NiceCircuits/solderingPen/measurements/test_load_photo.jpg

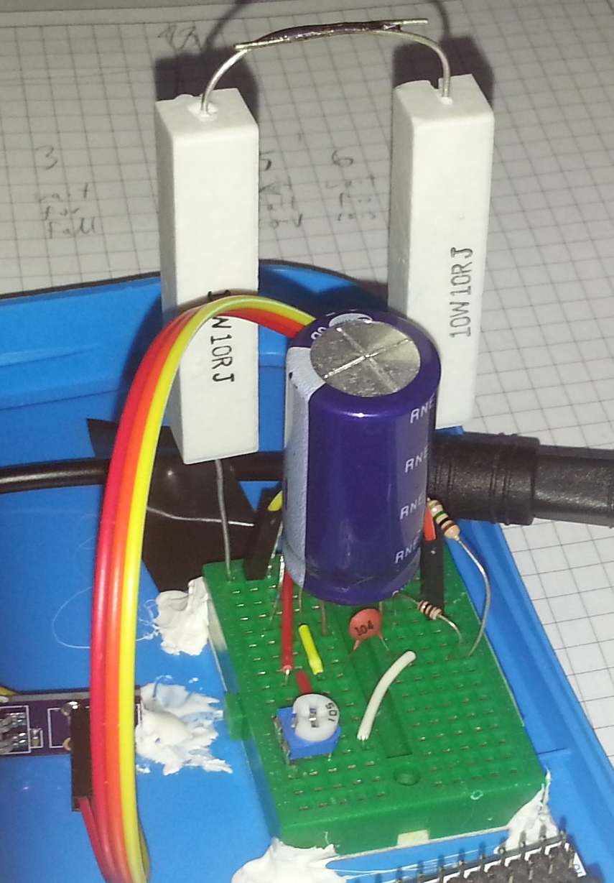
measurements/test_load_photo.jpg
