NiceCircuits/solderingPen/doc/img/bootloader_reception_1200.png

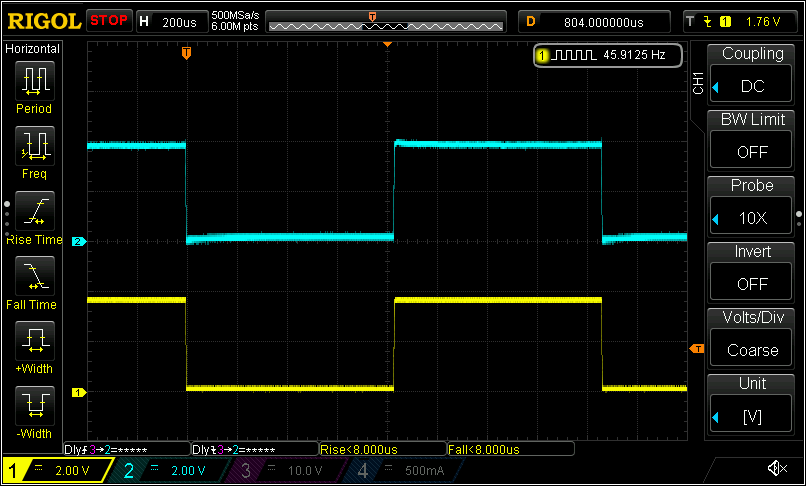
doc/img/bootloader_reception_1200.png
