NiceCircuits/solderingPen/doc/img/bootloader_reception_115200.png

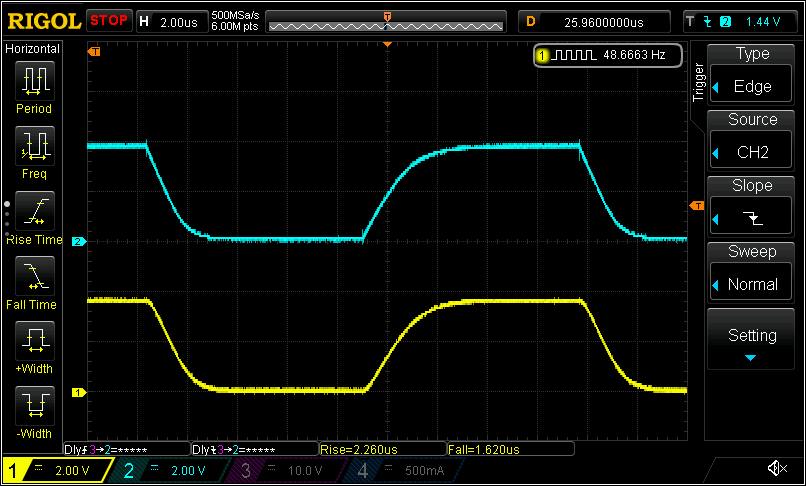
doc/img/bootloader_reception_115200.png
