NiceCircuits/solderingPen/doc/img/bootloader_reception_scm.png

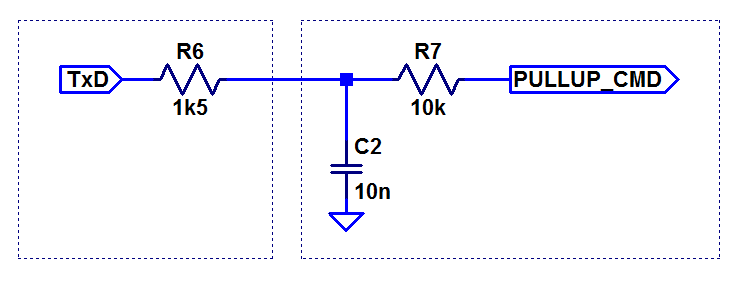
doc/img/bootloader_reception_scm.png
