NiceCircuits/solderingPen/doc/img/bootloader_transmission_high_side_2k2_220k.png

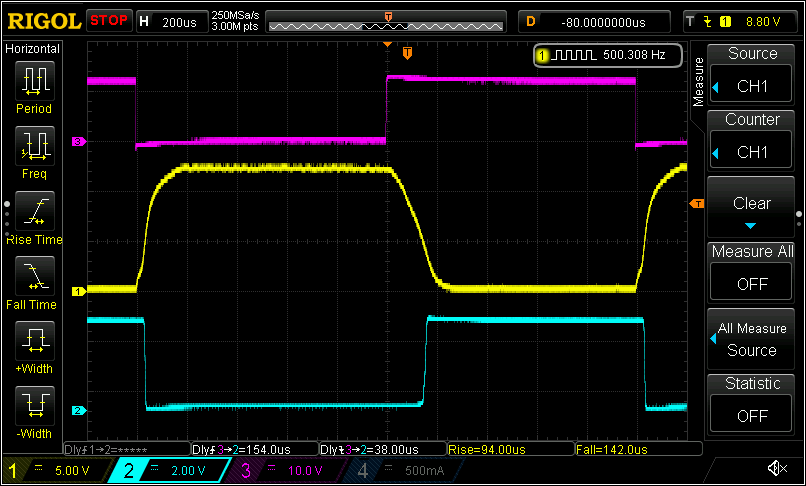
doc/img/bootloader_transmission_high_side_2k2_220k.png
