NiceCircuits/solderingPen/doc/img/bootloader_transmission_high_side_2k2_220k_bit_times.png

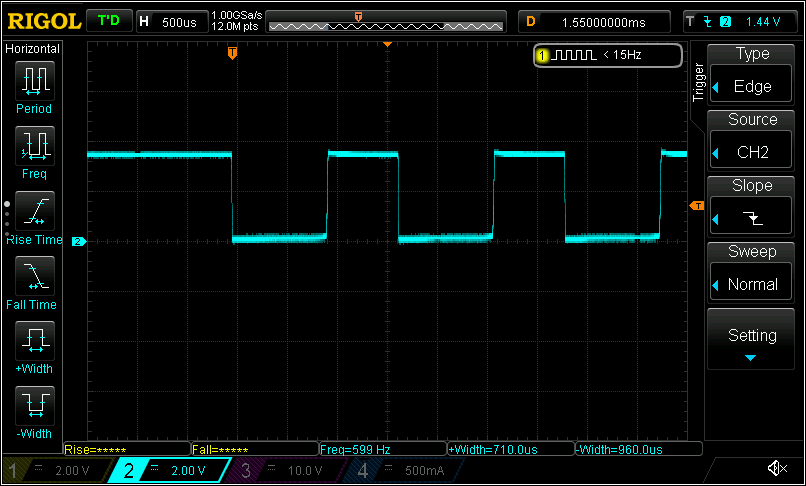
doc/img/bootloader_transmission_high_side_2k2_220k_bit_times.png
