NiceCircuits/solderingPen/doc/img/bootloader_transmission_high_side_only_transistor.png

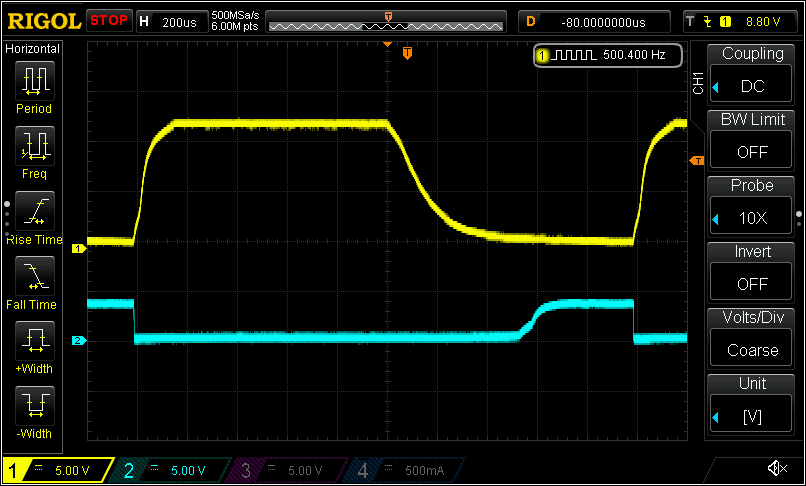
doc/img/bootloader_transmission_high_side_only_transistor.png
