NiceCircuits/solderingPen/doc/img/bootloader_transmission_high_side_scm.png

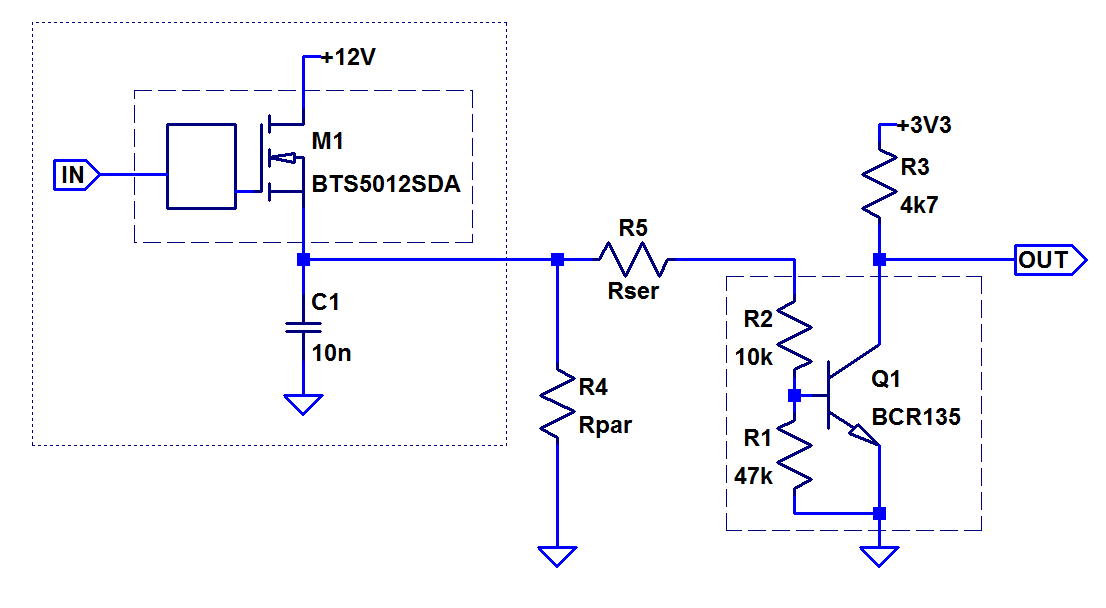
doc/img/bootloader_transmission_high_side_scm.png
