NiceCircuits/solderingPen/doc/img/BTS5012SDA_kilis.png

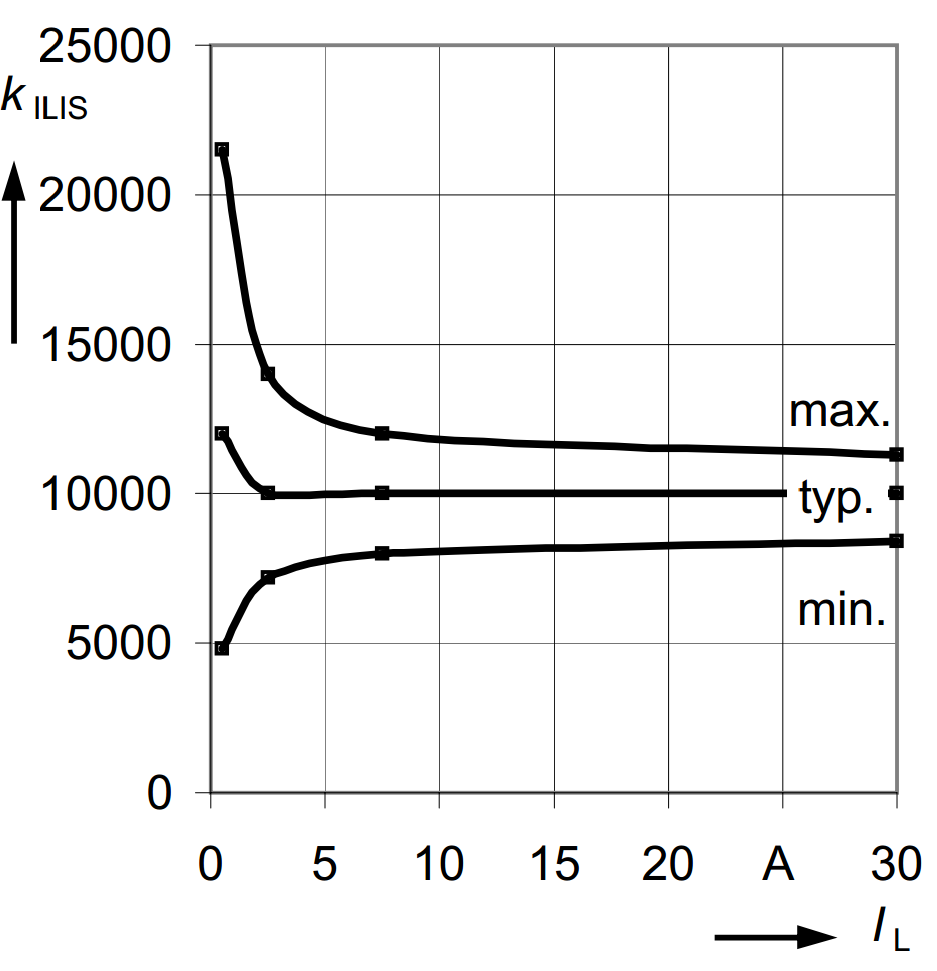
doc/img/BTS5012SDA_kilis.png
