NiceCircuits/solderingPen/doc/solderingPen_design.xlsm

Sheet: Summary
Soldering pen
For Weller RT tips
Block diagram:
 |  |  |  | High-side driver |  | uC |  | power supply | 12V in
 | Weller RT tip |  | heater
 |  |  | sensor | Op-amp
 |  |  |  | Magnetic sensor |  | RGB LED | Potentiometer | Buttons?
Main assumptions:
Tip rated voltage:
 |  | 12 | V
Tip rated power: |  |  |  | Safety factor for tip resistance
 |  | 40 | W |  | 110%
Power supply:
10-20V power supply - can be used with laptop power supply
min. | typ. | max.
10 | 12 | 20 | V
Non-fully operational power supply
uC is working, heater may be off
 | min. | max.
 | 8 | 30 | V
Reverse power supply protection
 | min. | max.
 | 0 | -30 | V
Ambient temperature:
min. | typ. | max.
0 | 25 | 40 | *C
Solder temperature
min. |  | max.
0 |  | 400 | *C
Output protection for:
Short between any pins
Open circuit on any pins
Connection to external voltage?

Sheet: Power supply
uC regulator
Supply voltage range:
Operational |  |  |  | Non operational
 | min. | max. |  | min. | max.
 | 10 | 20 | V | 8 | 30 | V
Reverse power supply protection
 | min. | max.
 | 0 | -30 | V
Diode or MOSFET can be used for reverse protection. As heater should be protected from reverse supply current, MOSFET will be used on the power supply input. It will be placed before uC regulator and heater driver.
Tip heater resistance, nominal:
 |  | 3.33 | Ω
Safety factor
 |  | 110%
Maximum input current (peak):
 |  | 6.6 | A
Regulator should withstand 30V. Simple 78L05/78L33 will withstand that.
Reverse protection P MOSFET:
IPD50P04P4-13
Max on resistance:
 |  | 12.6 | mΩ

Sheet: Heater driver
Heater driver
Power supply
min. | typ. | max.
10 | 12 | 20 | V
Tip heater resistance, nominal:
 |  | 3.33 | Ω
Safety factor
 |  | 110%
Current on nominal voltage - PWM up to 100%, safety factor included
 |  | 3.96 | A
Peak current on max. voltage
 |  | 6.60 | A
Max. PWM on max. voltage
 |  | 36%
Driver chosen:
BTS5012SDA
On-state resistance
 | typ. | max.
 | 12 | 24 | mΩ
Power dissipation
 | typ. | max.
 | 0.19 | 0.38 | W
Rthja, open air, typical
 |  | 80 | K/W
Temperature rise at max power output
 | typ. | max.
 | 15.054336 | 30.108672 | *C
Maximum temperature at max. ambient
 |  | 70.108672 | *C
Driver provides short circuit protection and output current measurement.

Sheet: Sensor amplifier
Sensor amplifier
Input thermocouple: K, thermal coefficient:
 | 41 | uV/*C
Op-amp: single supply, precision, at least lower rail capable input
Selected amplifier:
MCP6051
Offset voltage max. @25*C |  |  |  | Input bias current max.
 | 150 | uV |  |  |  | 5 | nA | Negligible
Offset voltage temp. drift |  |  |  | Offset voltage from temp. |  |  |  |  | Offset voltage max. @whole temp. range
 |  |  |  | @Tmin |  | @Tmax
 | 1.5 | uV/*C |  | 37.5 |  | 22.5 | uV |  | 187.5 | uV
Op-amp resistors |  |  |  |  |  |  |  | Stability, short time |  |  | Total error, short time, excl. tolerance
 | typ. |  | tolerance |  | temp. coef.
Rfb | 18 | kΩ | 1.0% |  | 100 | ppm/K |  | 0.2% |  |  | 0.5%
Rin | 0.1 | kΩ | 1.0% |  | 100 | ppm/K |  | 0.2% |  |  | 0.5%
Gain | typ. |  | tolerance, excl. op-amp offset |  |  |  |  | short time stability, excl. op-amp offset
 | 181 |  | 2.0% |  |  |  |  | 1.0%
Tout | max.
 | 400 | *C
Tamb. | min
 | 0 | *C
Vout @Tamb=min,Tout=max. |  |  |  |  |  | short time error, incl. op-amp offset
 | typ. |  | tolerance error |  |  |  |  |  |  | Vout max.
 | 2.97 | V | 0.06 | V |  | 0.06 | V |  |  | 3.09 | V
 |  |  | 8.0 | *C |  | 8.6 | *C

Sheet: uC
uC
Pins used: |  |  |  |  | Flash | 32 kB
2 | heater driver |  |  |  | SRAM | 6 kB
2 | sensor |  |  |  | Timers | 5
3 | LED |  |  |  | I2C | 1
1 | potentiometer |  |  |  | USART | 2
1 | Vin measurement |  |  |  | 12b ADC | 9
1 | Magnetic sensor |  |  |  | GPIO | 15
1 | Buttons?
11 | Total
uC selected:
STM32F070F6
in TSSOP20 package
pinout STM32F070F6
pin | main function | ADC | PWM | UART | I2C | other functions | signal
1 | BOOT0 |  |  |  |  |  | boot0
2 | PF0 |  |  |  | I2C1_SDA | OSC_IN | free
3 | PF1 |  |  |  | I2C1_SCL | OSC_OUT | free
4 | NRST |  |  |  |  |  | reset
5 | VDDA |  |  |  |  |  | VDDA
6 | PA0 | ADC_IN0 |  |  |  |  | vin_sense_sig
7 | PA1 | ADC_IN1 |  |  |  |  | driver_fb_sig
8 | PA2 | ADC_IN2 |  | USART2_TX |  |  | sensor_pullup_cmd
9 | PA3 | ADC_IN3 |  | USART2_RX |  |  | sensor_sig
10 | PA4 | ADC_IN4 | TIM14_CH1 |  |  |  | driver_cmd
11 | PA5 | ADC_IN5 |  |  |  |  | potentiometer_sig
12 | PA6 | ADC_IN6 | TIM3_CH1 TIM16_CH1 |  |  |  | led_R_cmd
13 | PA7 | ADC_IN7 | TIM3_CH2 TIM14_CH1 TIM1_CH1N TIM17_CH1 |  |  |  | led_G_cmd
14 | PB1 | ADC_IN9 | TIM3_CH4 TIM14_CH1 TIM1_CH3N |  |  |  | led_B_cmd
15 | VSS |  |  |  |  |  | VSS
16 | VDD |  |  |  |  |  | VDD
17 | PA9/PA11 |  | TIM1_CH2 TIM1_CH4 | USART1_TX | I2C1_SCL |  | SCL
18 | PA10/PA12 |  | TIM1_CH3 | USART1_RX | I2C1_SDA |  | SDA
19 | PA13 |  |  |  |  | SWDIO | SWDIO
20 | PA14 |  |  |  |  | SWCLK | SWCLK

Sheet: Other
Potentiometer
Selected potentiometer is CA6XVSMD-10KA2525. It's basically a trimmer, but with longer mechanical life (1000 cycles) than standard trimmers (100 cycles). It has also a couple of safts and thumbweels available.
6001 type thumbwheel is selected to ensure that change of temperature setting is available but not too easy.

Sheet: Notes
Read temperature when heater is off
Thermocouple is probably type D with cold junction compensation

Sheet: blank
Title
