NiceCircuits/solderingPen/doc/img/soldering_pen_block_diagram.png

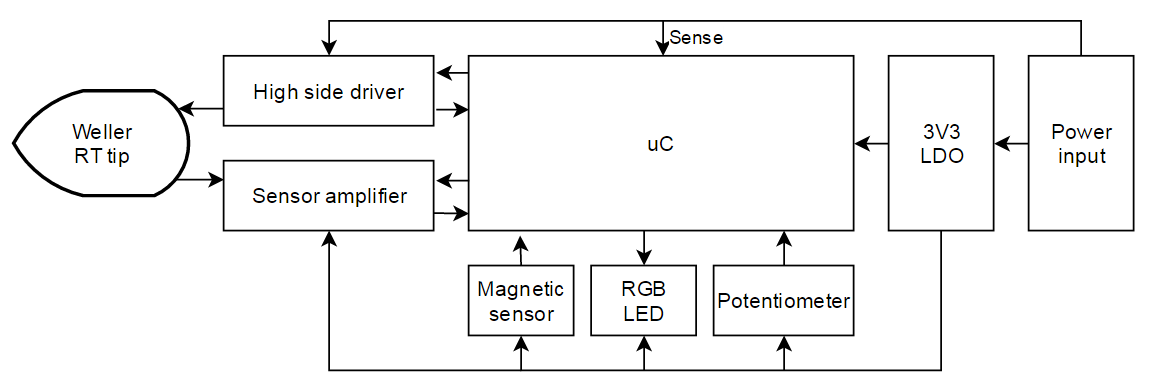
doc/img/soldering_pen_block_diagram.png
