NiceCircuits/solderingPen/measurements/MAG_test.xls

Sheet: Sheet1
 |  | 2 | 3 | 4
527 | 0 | 527 | -170 | -1958 | 2034.795567 | 1958
-170 | 1 | -239 | 257 | -3156 | 3175.453668 | 3156
-1958 | 2 | -534 | 418 | -3581 | 3644.645525 | 3581
-239 | 3 | -532 | 418 | -3586 | 3649.266228 | 3586
257 | 4 | 503 | -165 | -1971 | 2040.851538 | 1971
-3156 | 5 | 521 | -173 | -1943 | 2019.063892 | 1943
-534 | 6 | 520 | -170 | -1948 | 2023.364525 | 1948
418 | 7 | 522 | -168 | -1962 | 2037.192185 | 1962
-3581 | 8 | 522 | -173 | -1951 | 2027.020967 | 1951
-532 | 9 | 468 | -143 | -2030 | 2088.150617 | 2030
418 | 10 | -528 | 417 | -3579 | 3641.691091 | 3579
-3586 | 11 | -531 | 422 | -3586 | 3649.580935 | 3586
503 | 12 | -153 | 209 | -2996 | 3007.175751 | 2996
-165 | 13 | 520 | -172 | -1942 | 2017.758162 | 1942
-1971 | 14 | 523 | -174 | -1943 | 2019.666804 | 1943
521 | 15 | 524 | -172 | -1951 | 2027.451849 | 1951
-173 | 16 | 519 | -171 | -1939 | 2014.527984 | 1939
-1943 | 17 | 523 | -171 | -1952 | 2028.071498 | 1952
520 | 18 | 78 | 84 | -2642 | 2644.485583 | 2642
-170 | 19 | -528 | 420 | -3591 | 3653.828814 | 3591
-1948 | 20 | -532 | 419 | -3585 | 3648.398279 | 3585
522 | 21 | 180 | 12 | -2397 | 2403.7789 | 2397
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
