NiceCircuits/solderingPen/measurements/test_load_schematic.png

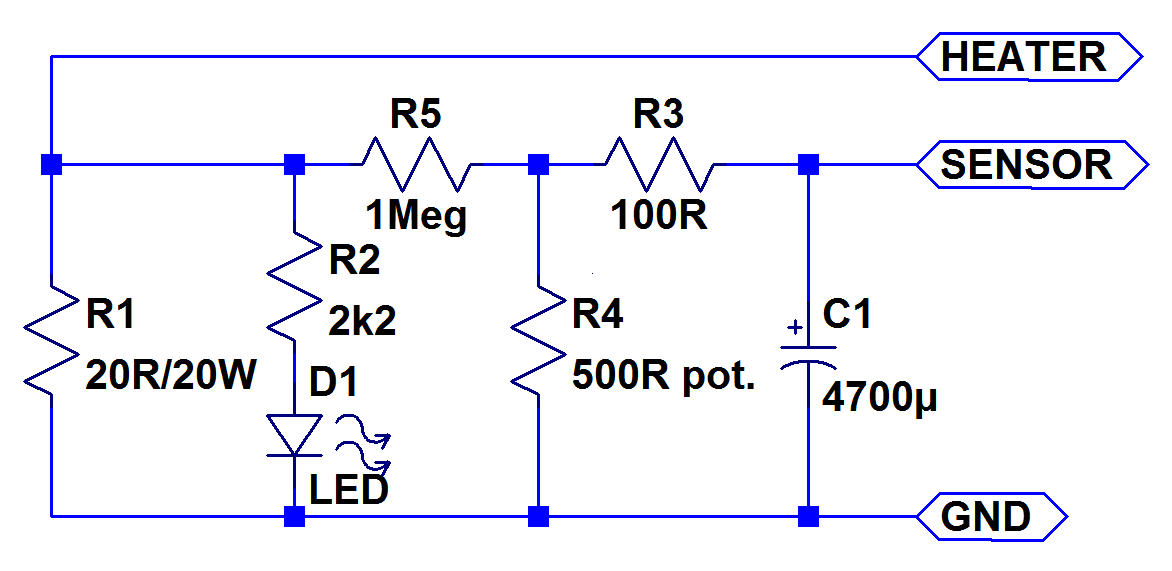
measurements/test_load_schematic.png
