NiceCircuits/solderingPen/pcb/solderingPen_assembly_bottom.pdf

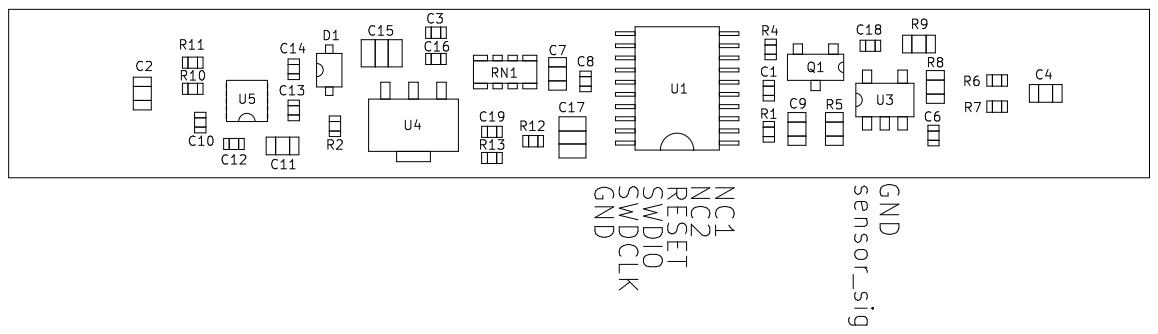
[picture p16: page 1]
