NiceCircuits/solderingPen/pcb/solderingPen_schematic.pdf

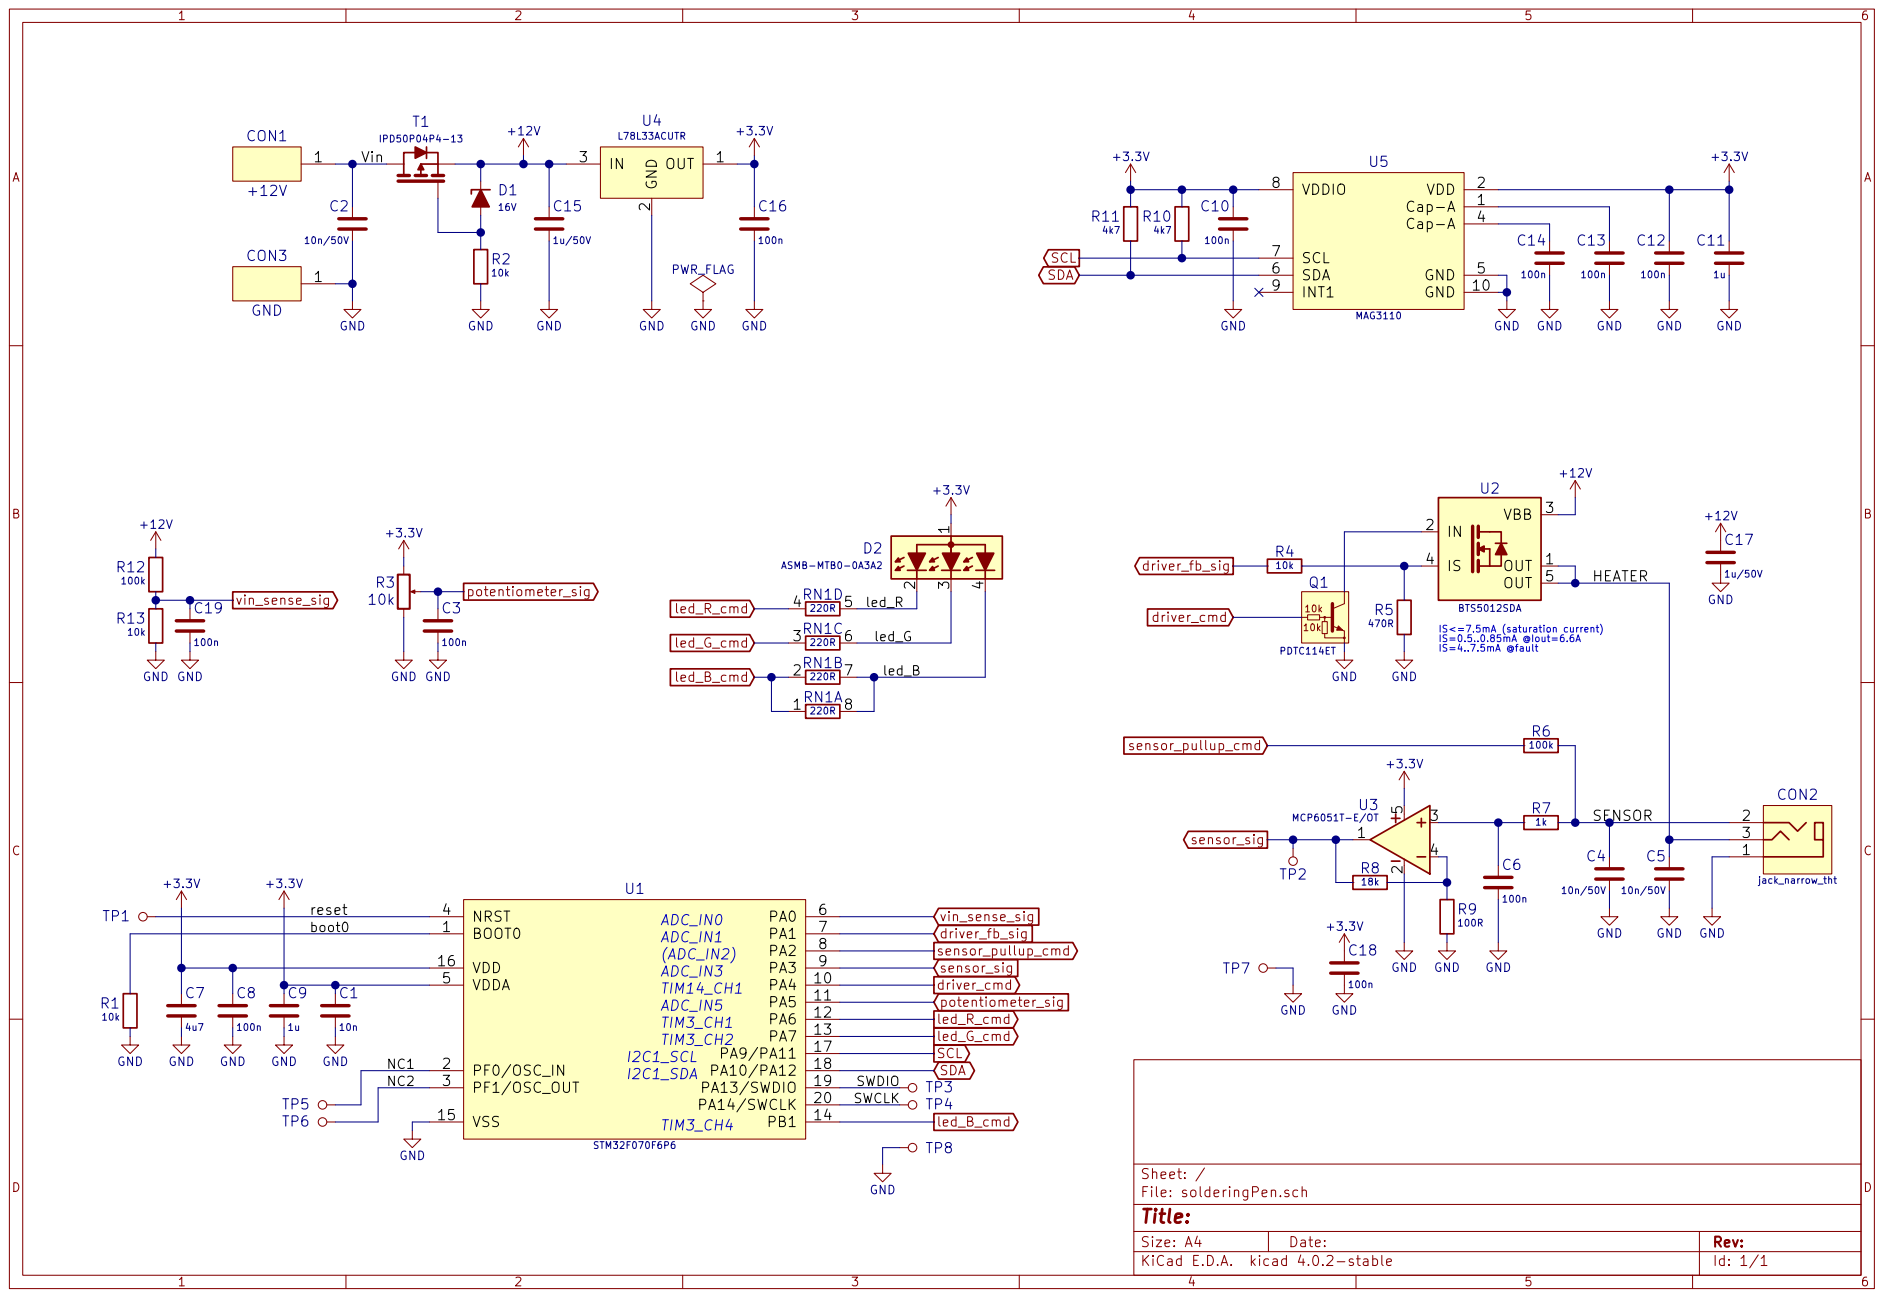
[picture p17: page 1]
