NiceCircuits/solderingPen/measurements/test_load_schematic.asc

C1: polcap; 4700µ
D1: LED
R1: res; 20R/20W
R2: res; 2k2
R3: res; 100R
R4: res; 500R pot.
R5: res; 1Meg
Named nets: GND, SENSOR, HEATER
