NiceCircuits/solderingPen/doc/img/bootloader_schematics.asc

C1: cap; 10n
C2: cap; 10n
M1: nmos; BTS5012SDA
Q1: npn; BCR135
R1: res; 47k
R2: res; 10k
R3: res; 4k7
R4: res; {Rpar}
R5: res; {Rser}
R6: res; 1k5
R7: res; 10k
R9: res; 1k
V1: voltage; PULSE(0 3.3 0 10n 10n 10u 20u)
Named nets: 0, +12V, +3V3, OUT, IN, HEATER, PULLUP_CMD, TxD
.tran 100u
.param Rpar 2k2
.param Rser 220k
