NiceCircuits/solderingPen/doc/img/bootloader_transmission_high_side_scm.asc

C1: cap; 10n
M1: nmos; BTS5012SDA
Q1: npn; BCR135
R1: res; 47k
R2: res; 10k
R3: res; 4k7
R4: res; Rpar
R5: res; Rser
Named nets: 0, +12V, +3V3, OUT, IN
