NiceCircuits/solderingPen/(commit log)

2016-04-12 Start design.
    [solderingPen.kicad_pcb, solderingPen.sch, solderingPen_design.xls]
2016-04-13 Optimize uC pin assignments. Place components on PCB.
    [solderingPen.kicad_pcb, solderingPen.sch, solderingPen_design.xls]
2016-04-14 Optimize uC pin assignments. Route PCB.
    [solderingPen.kicad_pcb, solderingPen.sch, solderingPen_design.xls]
2016-04-14 Routing, step 2. Fix some components.
    [solderingPen.kicad_pcb, solderingPen.sch]
2016-05-10 Finish PCB design.
    [solderingPen.kicad_pcb]
2016-05-10 Generate Gerber files
    [solderingPen.drl, solderingPen.gbl, solderingPen.gbo, solderingPen.gbs, solderingPen.gko, solderingPen.gtl, solderingPen.gto, solderingPen.gts]
2016-05-10 First blank firmware project (generated from STM32CubeMX).
2016-05-12 Playing with configurations. Add debug USART.
    [.custom.cfg, solderingPen_design.xls]
2016-05-14 Test software for ADC
    [.custom.cfg, test_ADC.cfg]
2016-05-14 Test ADC - update firmware, add measured values.
    [ADC_test.xls]
2016-05-19 Magnetometer test firmware.
    [.custom.cfg, test_mag.cfg]
2016-05-19 Add (temporary) debug UART.
2016-05-19 Change PWM frequency to 10 Hz. Remove old file.
2016-05-19 Add test results.
    [MAG_test.xls, adc_test1.csv, mag_test1.csv, mag_test2.csv]
2016-05-19 Ignore unnecessary files from magnetometer test.
2016-05-19 Cosmetic changes.
    [solderingPen.sch]
2016-05-19 Add heater and LED PWM drivers.
2016-05-20 ADC driver.
2016-05-21 Update heater driver. Add delay functions.
2016-05-21 Working on main loop. Add state machine. Other minor fixes.
    [adc.c, config.h, debug.c, led.h, main.c, solderingPen.ioc]
2016-05-22 Add heater regulator.
2016-05-23 Update values of sensor amplifier resistors.
    [solderingPen.kicad_pcb, solderingPen.sch]
2016-05-27 Update component values.
    [solderingPen.kicad_pcb, solderingPen.sch]
2016-06-02 Working on heater driver diagnostics.
2016-06-03 Add magnetometer driver
2016-06-05 Working on heater diagnostics.
2016-06-05 Regenerate project form STM32CubeMX without USART.
2016-06-07 Change debug interface to I2C.
2017-01-19 Add assembly drawings
    [solderingPen.kicad_pcb]
2017-03-02 Add design document
    [solderingPen_design.xlsm]
2017-03-04 Refactor. Add software_uart and led drivers.
2017-03-05 Refactor. Simplify LED driver.
2017-03-05 Software UART driver - transmission works.
2017-03-06 Software UASRT driver - working reception
    [solderingPen.cfg]
2017-03-11 Add test project for heater diagnostics
    [.custom.cfg, test_heater stlink2.cfg, test_heater.cfg]
2017-03-11 Add gerber files for PCB
    [solderingPen-B.Cu.gbr, solderingPen-B.Mask.gbr, solderingPen-B.Paste.gbr, solderingPen-B.SilkS.gbr, solderingPen-Edge.Cuts.gbr, solderingPen-F.Cu.gbr, solderingPen-F.Mask.gbr, solderingPen-F.SilkS.gbr]
2017-03-11 Increase bootloader reserved Flash, to be optimized. Little fix.
    [config.h, main.c]
2017-03-18 Add test app for bootloader testing
    [bootloader_test_app_to_load.xml, solderingPen.cfg]
2017-03-18 Optimize size of LED driver program size: 11924 (1192 less)
2017-03-20 Optimize size of GPIO driver. Slight fix of led driver. program size: 11788 11924 (136 less, -1328 saved total)
    [led.c, main.c]
2017-03-20 Optimize size of ADC driver. program size: 8836 (2954 less, 4282 saved total)
