NiceCircuits/solderingPen/(notices)

Notices in the files:
soft/bootloader_test_app_to_load/Src/main.c:
(C) COPYRIGHT STMicroelectronics *****END OF FILE
